mmandragiu/nepha/aplicatie/README.md

# NEPHA — aplicația de telefon (Flutter)

Aceeași casă ca pe panou și pe pagina casei, dar ca aplicație pentru Android și iPhone. Aplicația nu
ia nicio decizie: doar arată ce face casa și trimite comenzile noastre, prin panoul ESP32. Creierul
rămâne Arduino.

<p>
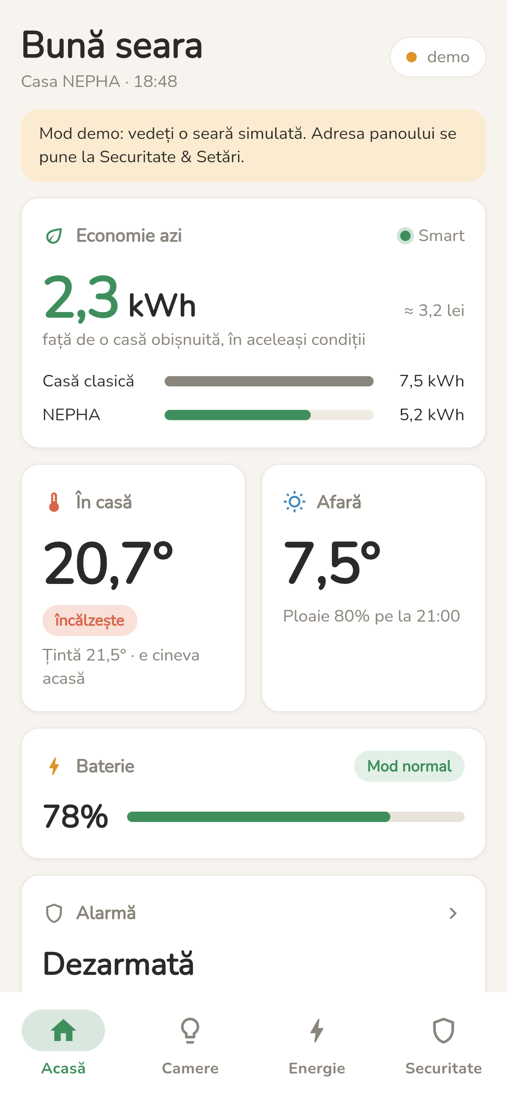
[picture p4: docs/imagini/aplicatie/acasa.png]
Acasă
  
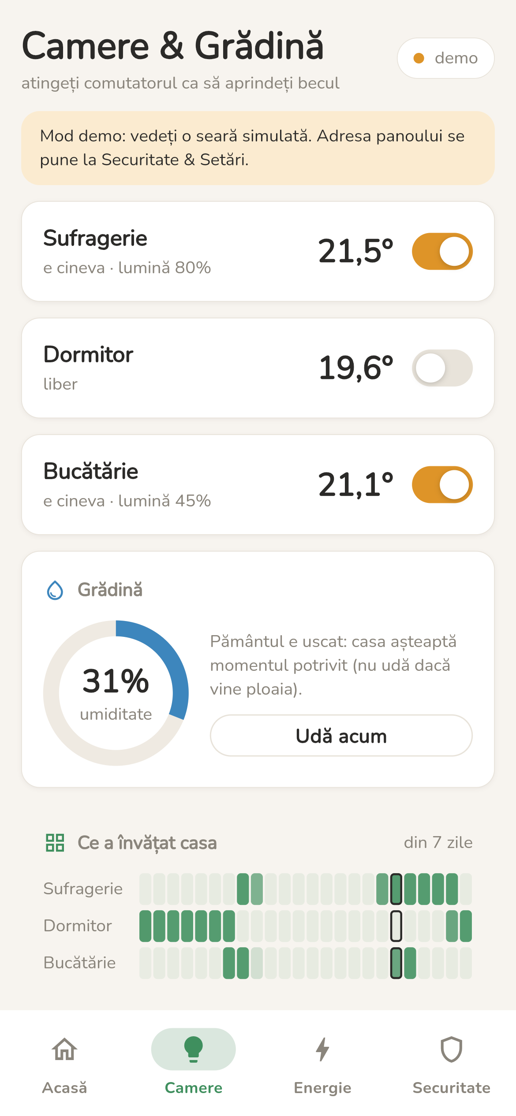
[picture p5: docs/imagini/aplicatie/camere.png]
Camere și grădină
  
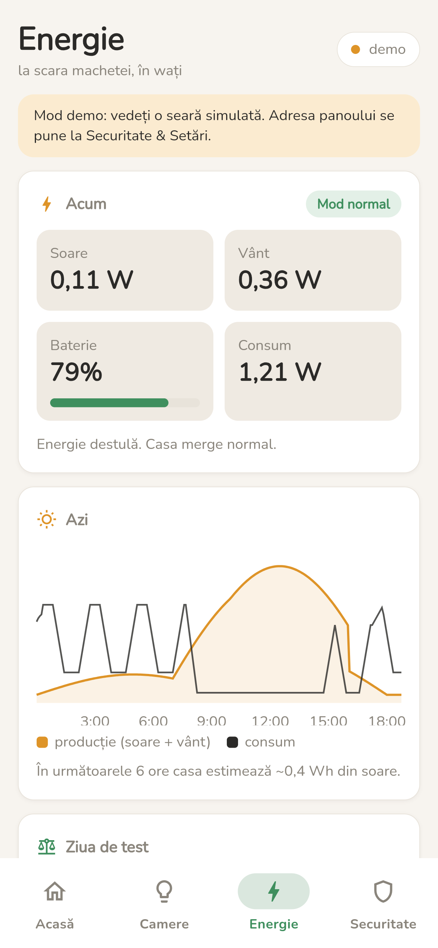
[picture p6: docs/imagini/aplicatie/energie.png]
Energie
  
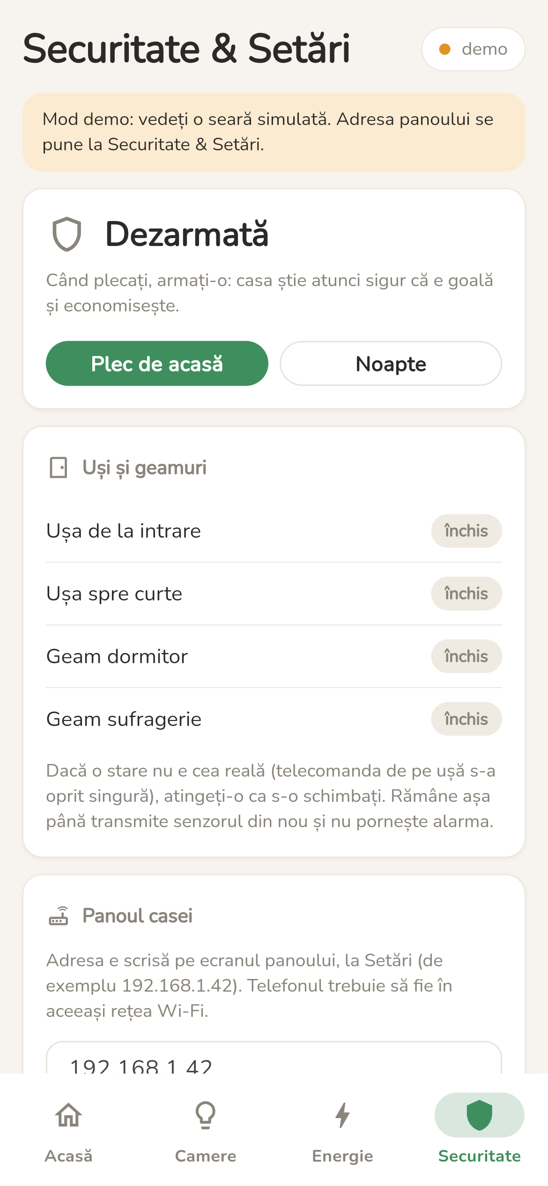
[picture p7: docs/imagini/aplicatie/securitate.png]
Securitate și setări
  
</p>

Patru file:

- **Acasă** — un rezumat într-o frază (alarma, temperatura medie, ce cere atenție), economia de
  azi față de o casă clasică (atinsă, deschide ziua de test: clasic vs NEPHA pe consumatori), cardurile cu cifrele casei, **automatizările** (regulile casei,
  colorate când lucrează) și jurnalul deciziilor;
- **Camere** — câte un card pe cameră (lumina se aprinde de aici; atins, deschide camera cu
  „Noapte / Relax / Citit / Plin”), priza TV, grădina cu „Udă acum” și ce a învățat casa;
- **Energie** — cât din consumul de acum vine din soare și vânt (semicercul), bateria în căsuțe,
  producția pe ore (bare; cu degetul alegi ora și vezi cât s-a produs atunci);
- **Securitate & Setări** — alarma (PIN, Face ID / Touch ID sau amprentă), ușile și geamurile (ținute
  apăsat, le corectezi starea dacă telecomanda de pe ușă s-a oprit singură), adresa panoului, modul
  demo, Smart / Clasic, temperatura de confort și tema (ca telefonul, zi sau noapte).

## Cum o pornim

Avem nevoie de [Flutter](https://docs.flutter.dev/get-started/install) și, pentru Android, de
**Android Studio** (aduce Android SDK-ul). Telefonul se leagă cu cablu USB, cu *USB debugging* pornit.

```
cd aplicatie
flutter pub get
flutter run
```

Fără telefon, se poate încerca și pe calculator: `flutter run -d windows` (merge și cu panoul
adevărat) sau `flutter run -d chrome` (în browser doar modul demo: panoul nu permite cereri din
pagini străine).

## Cum o legăm de casă

1. Telefonul în aceeași rețea Wi-Fi cu panoul (sau în rețeaua panoului, `NEPHA-casa`, parola `casa2026`).
2. Pe panou, la **Setări**, scrie adresa lui (de exemplu `192.168.1.42`; în rețeaua `NEPHA-casa` e
   `192.168.4.1`).
3. În aplicație, la **Securitate & Setări**: scriem adresa, apăsăm **Conectează**.

Sus, în dreapta, se vede legătura: verde = acasă, pe Wi-Fi, albastru = prin internet, galben = se
conectează sau Arduino nu răspunde, roșu = panoul nu răspunde. Fără panou, **modul demo** arată o seară simulată (e pornit la prima
deschidere), iar comenzile merg și acolo.

## Prin internet

Când telefonul nu e în Wi-Fi-ul casei (date mobile, alt Wi-Fi), aplicația merge prin brokerul MQTT
`mqtt.mandragiu.eu`. Trece singură de pe un drum pe altul. Cum funcționează, legarea telefonului de
casă și unde se pun parolele: [docs/prin-internet.md](../docs/prin-internet.md).

În aplicație nu e nicio parolă: fiecare telefon își primește contul lui pe broker de la panou,
când îl legăm de casă (Securitate & Setări → Leagă, cu codul de pe ecranul panoului), și îl ține
criptat pe telefon. APK-ul și IPA-ul se pot da oricui.

Graficul de la Energie are și „3 zile”: punctele se țin pe telefon (SQLite), ~50 KB.

## Alarma: PIN, Face ID, Touch ID sau amprentă

PIN-ul îl verifică Arduino, nu aplicația. Prima dată dezarmăm cu PIN-ul; dacă Arduino l-a acceptat și
dezarmarea fără PIN e pornită, aplicația îl păstrează criptat pe telefon (Keychain pe iPhone, Keystore
pe Android). Data viitoare telefonul ne recunoaște și aplicația trimite ea PIN-ul.

Aplicația vede singură ce are telefonul și așa scrie peste tot:

- iPhone cu Face ID (X și mai noi) — „Dezarmare cu Face ID”;
- iPhone cu buton (SE, 8) — „Dezarmare cu Touch ID”;
- Android — „Dezarmare cu amprenta”.

Dacă nu merge (fața nu e recunoscută, telefonul nu are nimic setat), cerem PIN-ul.

## Pe iPhone

Aplicația pentru iPhone se poate face doar pe un Mac, așa că o face GitHub pe un Mac al lui: pe
GitHub, la **Actions → Aplicatia → Run workflow** (cu „iPhone” bifat). După vreo 10 minute, jos la
**Artifacts** apare `NEPHA-iphone`, cu `NEPHA.ipa` înăuntru.

Fișierul nu e semnat. Ca să îl punem pe telefon, de pe Windows:

1. instalăm [Sideloadly](https://sideloadly.io) și iTunes (de pe site-ul Apple, nu din Microsoft Store);
2. legăm iPhone-ul cu cablu, îl tragem pe `NEPHA.ipa` în Sideloadly și ne logăm cu Apple ID-ul nostru;
3. pe iPhone: **Setări → General → VPN și gestionare dispozitive** → avem încredere în Apple ID-ul nostru;
   pe iOS 16 și mai nou mai trebuie pornit și **Setări → Confidențialitate → Mod dezvoltator**.

Cu un Apple ID obișnuit (gratuit), aplicația merge 7 zile, apoi o punem din nou (datele rămân). Cu
contul de dezvoltator Apple (99 $ pe an) merge un an și se poate da și altora, prin TestFlight.

## Cum e făcută

- Vorbește cu panoul exact ca pagina casei: `GET /api/stare` la 2 secunde, `POST /api/comanda`
  (vezi [docs/protocol.md](../docs/protocol.md) și [panou/web.ino](../panou/web.ino)).
- Dacă panoul nu răspunde în 3 secunde, renunțăm și scriem „Panoul nu a putut fi contactat”.
- Comutatoarele se mută pe loc și așteaptă confirmarea; dacă nu vine, revin.
- Panoul vorbește HTTP simplu (fără HTTPS): pe Android e permis în `AndroidManifest.xml`
  (`usesCleartextTraffic`), pe iPhone în `Info.plist` (doar rețeaua locală).
- La prima deschidere, iPhone-ul întreabă dacă aplicația poate căuta în rețeaua locală (panoul) și,
  la prima dezarmare, dacă poate folosi Face ID: la amândouă răspundem „Permite”.
- Tema de noapte: culorile sunt în `lib/theme/nepha_theme.dart`, câte un set pentru zi și unul pentru
  noapte. Când se schimbă, `main.dart` reface tot ecranul ca să le citească din nou.
- Fonturile sunt în aplicație (`assets/google_fonts`), merg și fără internet: Urbanist pentru
  text și cifre, JetBrains Mono doar pentru datele tehnice din „Date avansate”.

### Aspectul

- **Curat, fără efecte.** Carduri plate, cu colțuri mari: albe pe gri deschis ziua, grafit noaptea.
  Fără gradienți, fără strălucire.
- **Un singur accent: portocaliu.** Ce e pornit și butoanele principale sunt portocalii. Verdele e
  doar pentru economie și producție, roșul doar pentru alarmă.
- **Cifrele mari sunt scrise subțire** (de exemplu „2,3 kWh”), iar titlurile au o parte îngroșată
  („Casa ta, **pe scurt**”).
- **Sticla (ca „Liquid Glass” pe iPhone)** e doar pe ce plutește peste ecran: bara de jos și
  indicatorul de legătură. Ce trece pe sub ele se vede încețoșat. Cardurile rămân plate, cum
  recomandă Apple. E desenată de noi (`Sticla` în `lib/widgets/ui.dart`), deci arată la fel pe
  Android.
- **„Date avansate”.** Ții apăsat pe un card de pe Acasă și se deschide fereastra cu:
  - graficul pe 24 de ore;
  - de unde vine valoarea: senzorul, pinul, adresa I2C;
  - drumul până la telefon (Wi-Fi sau broker), latența în milisecunde și cât de proaspete sunt datele.

  Totul e în `lib/widgets/carduri.dart`.
- **Automatizările** (`lib/widgets/automatizari.dart`) sunt regulile scrise în Arduino. Aplicația
  nu le schimbă, doar arată care lucrează acum (cu portocaliu). Comutatorul de sus e Smart / Clasic.

| Fișier | Ce face |
|---|---|
| `lib/models/api_models.dart` | ce trimite panoul (aceleași câmpuri ca în `panou/web.ino`) |
| `lib/services/api_service.dart` | cererile către panou pe Wi-Fi (dio, 3 s) și seara simulată pentru modul demo |
| `lib/services/broker.dart` | aceleași cereri prin brokerul MQTT, PIN-ul criptat |
| `lib/services/istoric_local.dart` | graficul pe 3 zile, pe telefon |
| `lib/providers/app_state.dart` | starea aplicației: Wi-Fi sau internet, întrebările periodice, comenzile, setările, Face ID / amprenta |
| `lib/theme/nepha_theme.dart` | culorile (zi / noapte) și fonturile |
| `lib/widgets/ui.dart` | bucățile de bază: cardul, sticla, iconițe rotunde, pastile, butoane, comutatorul, bare, grafice mici |
| `lib/widgets/fereastra_camera.dart` | fereastra unei camere: lumina și scenele |
| `lib/widgets/carduri.dart` | cardurile de pe Acasă și „Date avansate” |
| `lib/widgets/automatizari.dart` | regulile casei, ca noduri „Dacă → Atunci” |
| `lib/widgets/` (restul) | graficul de energie, harta rutinei, tastatura PIN, ziua de test |
| `lib/screens/` | cele patru ecrane |

Înainte de a urca modificări: `flutter analyze` și `flutter test`.
