mmandragiu/nepha/docs/imagini/aplicatie/acasa-tot.png

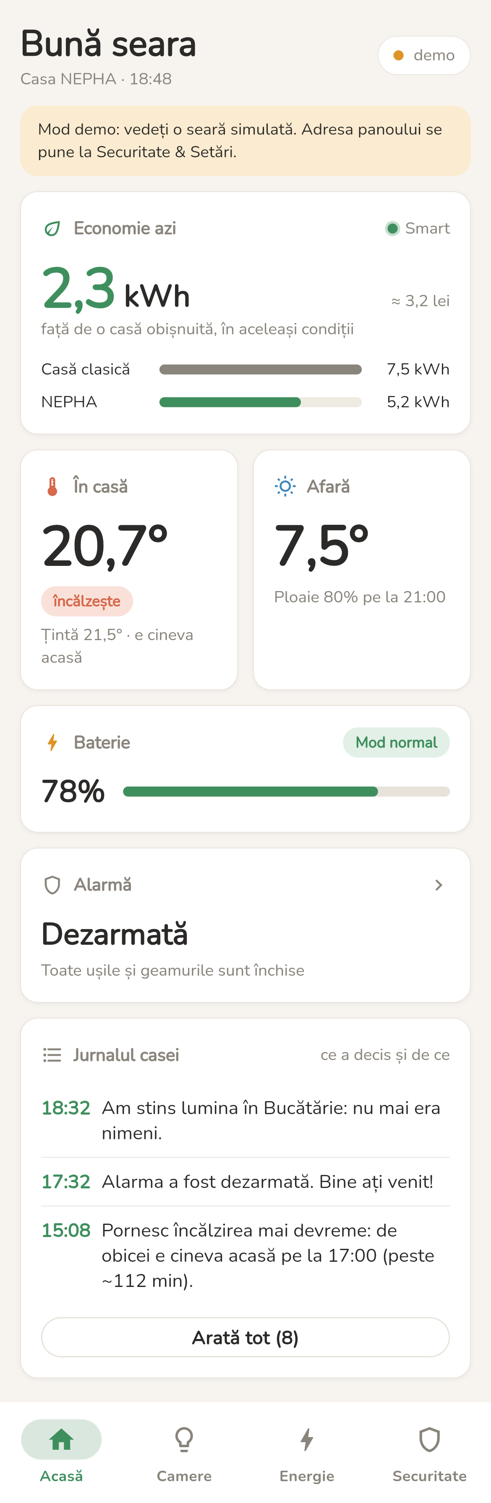
docs/imagini/aplicatie/acasa-tot.png
