mmandragiu/nepha/docs/imagini/aplicatie/energie-tot.png

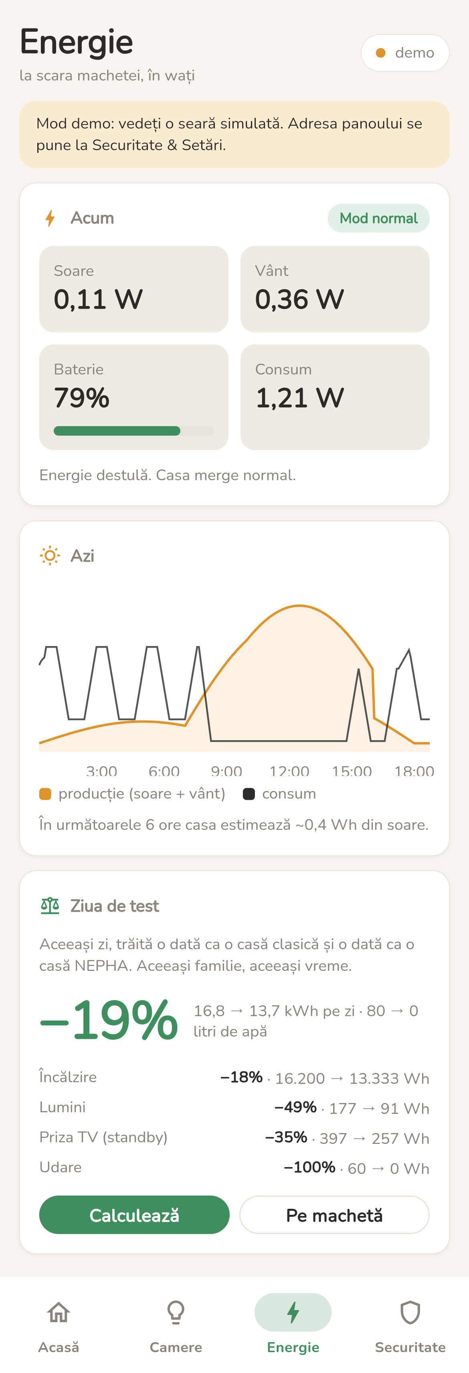
docs/imagini/aplicatie/energie-tot.png
