mmandragiu/nepha/docs/imagini/aplicatie/securitate-tot.png

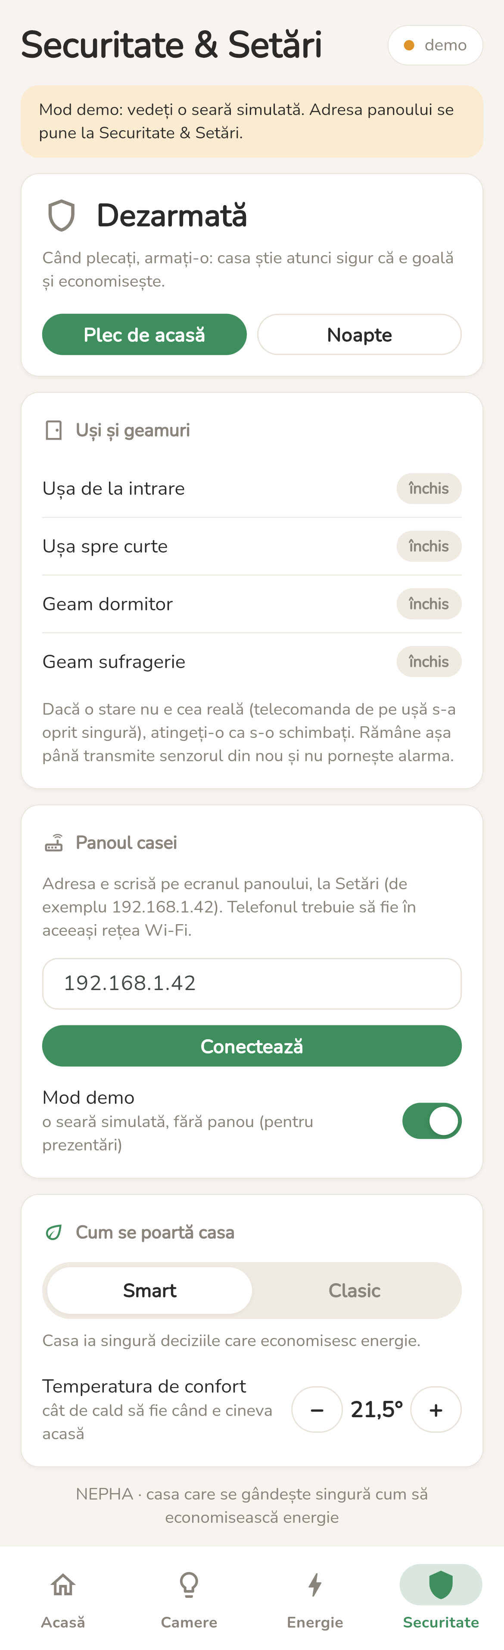
docs/imagini/aplicatie/securitate-tot.png
