mmandragiu/nepha/docs/imagini/panou-alarma.png

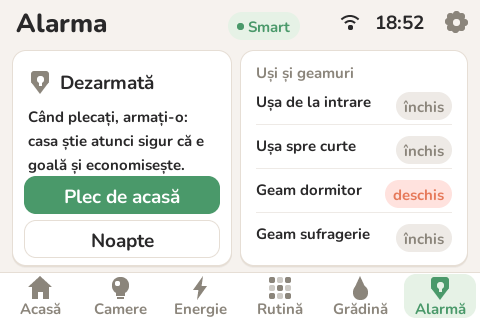
docs/imagini/panou-alarma.png
