mmandragiu/nepha/docs/imagini/panou-camere.png

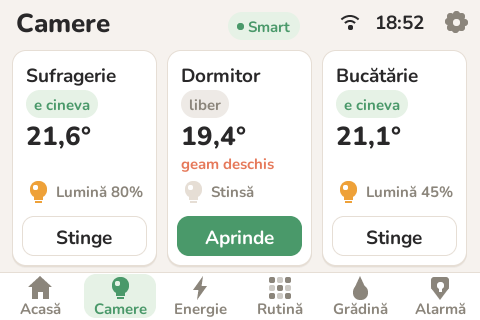
docs/imagini/panou-camere.png
