mmandragiu/nepha/panou/web_pagina.h

// Generat din web/index.html cu unelte/web_in_panou.mjs - nu se editeaza de mana.
// 42044 octeti de HTML, 13453 dupa comprimare.
#pragma once
#include <Arduino.h>

const uint8_t PAGINA_GZ[] PROGMEM = {
  0x1f, 0x8b, 0x08, 0x00, 0x00, 0x00, 0x00, 0x00, 0x02, 0x0a, 0xad, 0x7d, 0x5d, 0x73, 0xe3, 0xb6, 0x96, 0xe0, 0xbb, 0x7f,
  0xc5, 0x69, 0xa6, 0x3f, 0xa4, 0x36, 0x49, 0x91, 0x92, 0x2c, 0xdb, 0xb2, 0xe5, 0x8c, 0xdb, 0xed, 0xbe, 0x93, 0xdd, 0x74,
  0xdf, 0xae, 0x74, 0x72, 0xef, 0xee, 0x78, 0xbd, 0x1b, 0x98, 0x82, 0x2c, 0xc4, 0x14, 0xc9, 0xe1, 0x87, 0xec, 0xb6, 0xe3,
  0xa9, 0xa9, 0xed, 0xaa, 0xad, 0xd9, 0xaa, 0xad, 0x79, 0x98, 0x79, 0xca, 0xe6, 0xed, 0xbe, 0x4e, 0xd5, 0xd4, 0xbc, 0xed,
  0xc3, 0xbc, 0xdd, 0xf4, 0x43, 0xff, 0x8e, 0xfb, 0x4b, 0xb6, 0xce, 0x01, 0x40, 0x82, 0x14, 0x65, 0xbb, 0x33, 0xe9, 0x54,
  0x64, 0x8a, 0x00, 0x0e, 0x80, 0x83, 0x83, 0xf3, 0x0d, 0x68, 0xff, 0xd1, 0x34, 0x0e, 0xf2, 0xf7, 0x09, 0x87, 0x79, 0xbe,
  0x08, 0x0f, 0x36, 0xf6, 0xf1, 0x0f, 0x84, 0x2c, 0x3a, 0x9f, 0x58, 0x69, 0x6c, 0xe1, 0x0b, 0xce, 0xa6, 0x07, 0x1b, 0xfb,
  0x0b, 0x9e, 0x33, 0x08, 0xe6, 0x2c, 0xcd, 0x78, 0x3e, 0xb1, 0x8a, 0x7c, 0xe6, 0xec, 0x58, 0xfa, 0x75, 0xc4, 0x16, 0x7c,
  0x62, 0x2d, 0x05, 0xbf, 0x4c, 0xe2, 0x34, 0xb7, 0x20, 0x88, 0xa3, 0x9c, 0x47, 0xf9, 0xc4, 0xba, 0x14, 0xd3, 0x7c, 0x3e,
  0x99, 0xf2, 0xa5, 0x08, 0xb8, 0x43, 0x5f, 0x6c, 0x10, 0x91, 0xc8, 0x05, 0x0b, 0x9d, 0x2c, 0x60, 0x21, 0x9f, 0xf8, 0x36,
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
  0xb7, 0x71, 0xbb, 0xf1, 0x57, 0xb4, 0xf9, 0xe0, 0xae, 0xbd, 0x47, 0x24, 0x56, 0x11, 0x5b, 0x49, 0x6e, 0x72, 0xfb, 0x1a,
  0xe4, 0xd6, 0xf7, 0xfd, 0x57, 0xfe, 0x0b, 0x83, 0xdc, 0x06, 0xc3, 0x81, 0xd7, 0x37, 0xc9, 0xed, 0x55, 0xff, 0xf8, 0xe5,
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
};
