mmandragiu/nepha/panou/radacini.h

// radacini.h - certificatele radacina Let's Encrypt (ISRG Root X1 si X2)
// Cu ele verificam ca vorbim chiar cu brokerul si cu serverul de conturi (amandoua au
// certificate Let's Encrypt), nu cu cineva care se da drept ele.
#pragma once

static const char RADACINI[] PROGMEM = R"(
-----BEGIN CERTIFICATE-----
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
-----END CERTIFICATE-----
-----BEGIN CERTIFICATE-----
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
/q4AaOeMSQ+2b1tbFfLn
-----END CERTIFICATE-----
)";
