mmandragiu/nepha/(commit log)

2026-10-08 schelet: creierul casei pe Arduino Uno
2026-10-08 senzori: temperaturi, miscare, lumina, sol si INA219
2026-10-08 lumini pe camere, priza TV si modurile de energie
2026-10-08 ziua de test: aceeasi zi clasic si smart
2026-10-08 panoul: Wi-Fi, prognoza meteo si legatura cu Arduino
2026-10-13 panou: ecranul Acasa refacut, umbre fine, treceri si bara bateriei animata
    - insigna (preincalzire / geam deschis) are randul ei, nu mai calca peste temperatura
    - randuri egale pe Acasa, fasia cu ultima decizie chiar deasupra filelor
    - fila deschisa sta pe o pastila verde, Wi-Fi desenat ca iconita
    - punctul din pastila Smart pulseaza
    - o stare noua apare in 200 ms, bara bateriei aluneca in 0,5 s
    - pe cardul mic alarma scrie scurt (Armata (plecat) iesea din card)
    - Energie: procentul bateriei nu mai calca pe marginea umplerii
2026-10-13 pagina: fara gradienti si fara cardul negru, carduri mai linistite
    - colturi de 14 px, umbra fina, cardul se ridica 2 px la hover
    - etichetele scrise normal, iconite fara patratele colorate
    - inelul de la gradina e un cerc SVG, graficul are umplere plata
    - starile noi apar in 200 ms, bara bateriei aluneca in 0,5 s
    - punct verde care pulseaza in butonul Smart
2026-10-24 casa: vorbim cu panoul pe I2C, prin translator, cum e montat
    - Arduino e la adresa 8 pe A4/A5 (aceleasi fire ca INA219); panoul intreaba
    - legatura.h se poarta ca un port serial, restul programului nu stie de I2C
    - daca panoul e ocupat, nu-l asteptam: alarma si senzorii sunt mai importante
    - USA <senzor> 0|1: usa pusa de mana din panou, ramane asa pana transmite senzorul
    - 2 s fara semnal = usa inchisa (telecomenzile transmit cat e deschisa)
    - fara AltSoftSerial: D8/D9 raman libere
2026-10-24 panou: I2C spre Arduino (IO21/IO22), starea usii se schimba atingand-o
    - pe ecranul Alarma: numele senzorului = il invatam, starea = o schimbam
    - la fel pe pagina de telefon (si in modul demo)
2026-10-24 casa virtuala si documentatie: legatura pe I2C, telecomenzile de pe usi
2026-10-24 casa: mai mica, ca sa intre si pe Uno-urile cu bootloader vechi (30720 octeti)
    - pe Serial evenimentele apar ca E <cod> (in cuvinte raman pe panou)
    - texte mai scurte pe Serial Monitor; programul are acum 30584 de octeti
2026-10-25 aplicatia de telefon (Expo): aceleasi ecrane ca pagina casei
    - vorbeste cu panoul ca pagina: /api/stare la 2 s, /api/comanda
    - legatura se vede sus (verde / galben / rosu); dupa 3 s fara raspuns renuntam
    - comutatoarele se muta pe loc si revin daca panoul nu confirma
    - mod demo cu seara simulata, pentru prezentari fara panou
    - aceleasi culori, colturi si font (Nunito) ca pagina si panoul
2026-10-25 scot aplicatia de telefon, o refacem
2026-10-25 aplicatia de telefon, refacuta in Flutter
    - patru file: Acasa, Camere & Gradina, Energie, Securitate & Setari
    - modelele urmeaza exact JSON-ul panoului (panou/web.ino); dio cu 3 s de asteptare
    - starea la 2 s, legatura verde / galben / rosu, comutatoare care revin daca panoul nu confirma
    - amprenta / Face ID deblocheaza PIN-ul pastrat criptat (il verifica tot Arduino)
    - HTTP local permis pe Android si iPhone, fontul Nunito in aplicatie
    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
2026-10-25 aplicatia pe iPhone: Face ID / Touch ID, iconita, compilare pe Mac-ul de la GitHub
2026-10-25 aplicatia: tema de noapte (ca telefonul, zi sau noapte), la Securitate & Setari
2026-10-26 aplicatia: ecranul Camere nu se mai deruleaza in gol (orele de sub harta rutinei)
2026-10-26 casa si prin internet: panoul si aplicatia vorbesc prin brokerul MQTT cand telefonul nu e pe Wi-Fi-ul casei
    - panou: mqtt.ino (legatura TLS pe nucleul 0, cereri/raspunsuri/noutati pe topicele din ACL),
    imperechere.ino (numele unic al panoului, cheia casei, codul de pe ecran, PIN-ul criptat)
    - aplicatia: trece singura intre Wi-Fi si internet, legarea telefonului de casa,
    PIN-ul pleaca criptat (AES-256-GCM), graficul pe 3 zile tinut pe telefon (SQLite)
    - parolele stau doar in fisiere ignorate de git (secrete.h, secrete.json); vezi docs/prin-internet.md
2026-10-26 proba_broker: panoul de proba raspunde si pe Wi-Fi, cu legare si PIN criptat
2026-10-26 brokerul: conturi pe fiecare panou si fiecare telefon, de la serverul de conturi
    - panoul se inroleaza singur (POST /enroll/server) si tine contul in memoria lui;
    daca brokerul nu-l mai accepta, cere parola noua (reset)
    - telefoanele le inroleaza panoul, la legarea cu codul de pe ecran; telefonul tine contul
    in flutter_secure_storage
    - in aplicatie nu mai e nicio parola: fara secrete.json si fara GitHub Secrets
    - cheile de inrolare stau doar in panou/secrete.h (ignorat de git)
2026-10-27 aplicatia: aspect nou, curat - carduri plate, accent portocaliu, noaptea grafit, fontul Urbanist; pe Acasa economia zilei, cardurile cu date avansate (tinute apasat) si automatizarile; bara de jos di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
2026-10-27 aplicatia: PIN gresit = mesaj; dupa prima dezarmare cu PIN intreaba de Face ID / amprenta; comutatorul lor sta langa alarma; in demo scrie PIN-ul
2026-10-27 aplicatia: mai putin text (explicatiile sub un (i)); la Energie productia pe ore in bare, alegi ora cu degetul; ziua de test se deschide din Economie azi; usile se corecteaza tinute apasat, cu intreb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
2026-10-27 panoul: textele scurtate la fel ca in aplicatie
2026-10-28 aplicatia: la grafic cifra orei apare doar cand atingi bara sau tii degetul pe grafic
2026-10-29 hardware-ul din camera reala: DHT11 pe D3 (temperatura si umiditatea in dormitor), becul bucatariei mutat pe D9, Livolo prin emitatorul de pe D8 (aprins/stins sigur, legare din aplicatie), placa din 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
2026-10-29 gradina: pinii finali (releele 1-4 pe GPIO 6, 4, 15, 7; ploaia DO pe 1, AO pe 2); Livolo se aprinde doar de la 30% (lumina de noapte nu mai aprinde lustra); DHT11 netezit si prag mai mare la geamul d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
2026-10-29 fara senzori de miscare si fotorezistenta: "acasa" vine de la alarma, luminile le aprinde omul si NEPHA le stinge la Plecat, lumina de afara estimata dupa ora si prognoza; gradina cu 3 zone; Livolo e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
2026-10-29 fara senzori de miscare: rutina apare ca un singur rand "Acasa" (pe panou si in aplicatie), fereastra camerei nu mai arata dala Miscare, iar in loc de regulile cu miscare apare "Plecati de acasa -> S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
2026-10-29 fara senzori de miscare, fereastra camerei nu mai are "Lasa casa sa decida" (nu avea ce face) si scrie ca lumina ramane cum ai ales-o pana pleci
